thelateperseus/ball-and-plate/README.md

Ball and Plate Balancing System
===============================

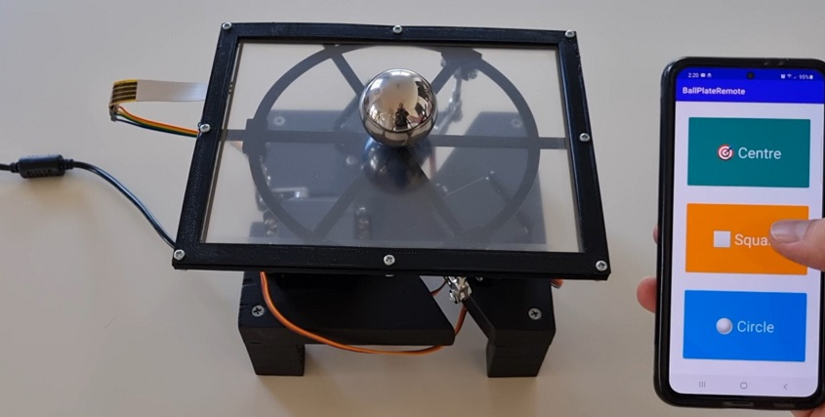
[picture p1: instructions/BallAndPlate.jpg]


https://youtu.be/56UyDa0NHvM

If you're interested in building one of your own, check out the [instructions](instructions/README.md).
