thelateperseus/ball-and-plate/instructions/Parts.md

Parts List
==========

All prices are in Australian Dollars.

Note that I am not making any statement about the quality of these parts. I used them in my build, but you should review the parts to make sure they are suitable for your purpose.

Mechanism
---------

| Part  | Price | Quantity |
| --- | --- | --- |
| [18mm thick pine panel](https://www.bunnings.com.au/300-x-18mm-x-1-2m-pine-utility-panel_p0019145) for base, at least 170mm x 150mm | $29.00 | 1 |
| [42mm x 19mm pine DAR](https://www.bunnings.com.au/porta-42-x-19mm-1-8m-premium-pine-dar_p0211230) for legs | $6.75 | 1 |
| [Aluminum Standoff: 1/4" Length, 2-56 Thread, M-F (4-Pack)](https://core-electronics.com.au/aluminum-standoff-1-4-length-2-56-thread-m-f-4-pack.html) | $2.05 | 1 |
| [Machine Screw: #2-56, 1/4" Length, Phillips (25-pack)](https://core-electronics.com.au/machine-screw-2-56-1-4-length-phillips-25-pack.html) | $1.65 | 1 |
| [4X MG996R Digital Metal Gear Servo](https://www.banggood.com/4X-MG996R-Digital-Metal-Gear-Servo-For-Robot-ZOHD-Volantex-Airplane-RC-Helicopter-Car-Boat-Model-p-961727.html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) | $36.73 | 1 |
| [Multifunction Servo Motor Bracket Steering Head for MG996R](https://www.ebay.com.au/itm/172475926539) | $4.48 | 3 |
| [1PC Aluminum 28.3mm 25T Teeth Tooth Steering Half Servo Arm Horn for 1/10 Rc Car HSP Wltoys - Silver](https://www.banggood.com/1PC-Aluminum-28_3mm-25T-Teeth-Tooth-Steering-Half-Servo-Arm-Horn-for-1-or-10-Rc-Car-HSP-Wltoys-p-1335836.html?ID=227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) | $9.03 | 3 |
| [M4 Aluminum Fisheye Ball Bearing Rod Ends Joint](https://www.banggood.com/M3-or-M4-Aluminum-Fisheye-Ball-Bearing-Rod-Ends-Joint-Thread-Fish-Eye-For-3D-Printer-p-1304307.html?ID=514514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) | $2.45 | 3 |
| [G-FORCE ALUMINIUM CLEVIS HEAVY DUTY M4 (X2)](https://www.frontlinehobbies.com.au/g-force-aluminium-clevis-heavy-duty-m4-x2-gf-2110) | $11.99 | 2 |
| [8" 4 Wire Resistive LCD Touch Screen](https://www.ebay.com.au/itm/180926055286) | $30.99 | 1 |
| [M3 x 10mm Steel Screws - Pk.25](https://www.jaycar.com.au/m3-x-10mm-steel-screws-pk-25/p/HP0403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) | $3.00 | 1 |
| [3mm Flat Steel Washers - Pk.25](https://www.jaycar.com.au/3mm-flat-steel-washers-pk-25/p/HP0430) | $3.00 | 1 |
| [M4 x 20mm Zinc Plated Round Head Bolts And Nuts - 16 Pack](https://www.bunnings.com.au/pinnacle-m4-x-20mm-zinc-plated-round-head-bolts-and-nuts-16-pack_p0168397) | $3.56 | 1 |
| [30mm M4 screws for servo brackets - 100 Pack](https://au.element14.com/tr-fastenings/m4-30-prstmc-z100/screw-pozi-pan-steel-bzp-m4x30/dp/1419998) | $4.32  | 1 |
| [M4 Steel Flat Washer - Pk.25](https://www.jaycar.com.au/m4-steel-flat-washer-pk-25/p/HP0465) | $3.50 | 1 |
| M4 nuts | ??? | 15 |
| M3 nuts | ??? | 11 |
| 8G self-tapping screws for legs | ??? | 4 |

Electronics
---------

| Part  | Price | Quantity |
| --- | --- | --- |
| [Arduino Nano Every](https://core-electronics.com.au/arduino-nano-every.html) | $22.95 | 1 |
| [Pololu 5V Step-Up/Step-Down Voltage Regulator S7V7F5](https://core-electronics.com.au/pololu-5v-step-up-step-down-voltage-regulator-s7v7f5.html) | $19.60 | 1 |
| [Bluetooth Module (HC-05)](https://core-electronics.com.au/bluetooth-module-hc-05.html) | $33.50 | 1 |
| [DC POWER JACK, 8A, 20VDC, BLACK](https://au.element14.com/global-connector-technology/dcj250-20-b-k1-a/dc-power-jack-8a-20vdc-black/dp/2524132) | $2.10 | 1 |
| [Electrolytic Decoupling Capacitors - 1000uF/25V](https://core-electronics.com.au/electrolytic-decoupling-capacitors-1000uf-25v.html) | $0.55 | 1 |
| [Schottky Diode](https://core-electronics.com.au/schottky-diode.html) | $0.24 | 1 |
| 180 Ohm resistor | ??? | 1 |
| 1k Ohm resistor | ??? | 1 |
| 2k Ohm resistor | ??? | 1 |
| [T1 (3mm) Yellow LED with Yellow Diffused Lens](https://core-electronics.com.au/t1-3mm-yellow-led-with-yellow-diffused-lens.html) | $0.30 | 1 |
| [0.100" (2.54 mm) Female Header: 1x3-Pin, Straight](https://core-electronics.com.au/0-100-2-54-mm-female-header-1x3-pin-straight.html) | $0.54 | 1 |
| [0.100" (2.54 mm) Female Header: 1x6-Pin, Right-Angle](https://core-electronics.com.au/0-100-2-54-mm-female-header-1x6-pin-right-angle.html) | $0.78 | 1 |
| [0.100" (2.54 mm) Breakaway Male Header: 1x40-Pin, Straight](https://core-electronics.com.au/0-100-2-54-mm-breakaway-male-header-1x40-pin-straight.html) | $1.20 | 1 |
| [40 Pin - Female Headers](https://core-electronics.com.au/female-headers.html) | $2.40 | 1 |
| [Jumper (busbar)](https://au.element14.com/wurth-elektronik/60910813421/jumper-8pos-2-54mm-header-conn/dp/2827863) | $1.31 | 1 |
| [MICRO USB Metal Dust Plug Cover](https://www.ebay.com.au/itm/283712585867) | $3.95 | 1 |

Other
---------

| Part  | Price | Quantity |
| --- | --- | --- |
| [AC DC Power Supply 5V 8A Transformer 40W Adapter 10A AU Plug](https://www.ebay.com.au/itm/123865462464) | $31.85 | 1 |
| [Precision Ball 38mm Solid Chrome Steel G25 for Bearing](https://www.ebay.com.au/itm/352871824460) | $15.43 | 1 |
