thelateperseus/ball-and-plate/CADv2/mservobracket.stl

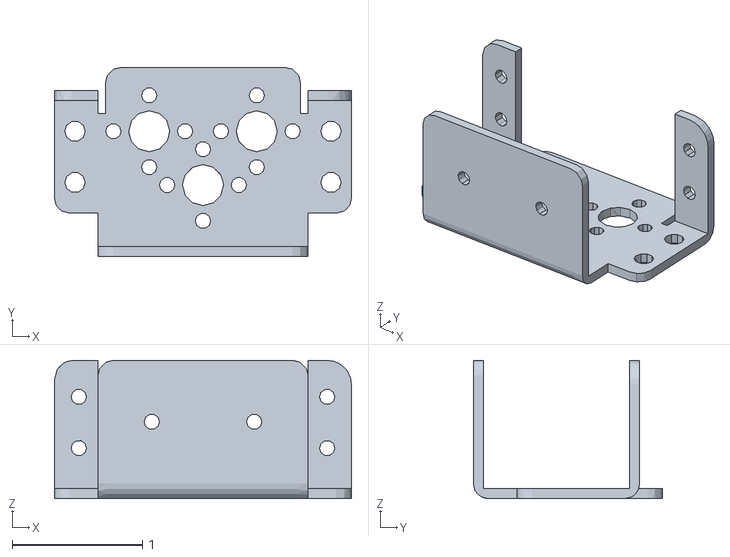
[picture p2: CAD file, 2021-02-15]
CADv2/mservobracket.stl
2.28 x 1.46 x 1.06
