thelateperseus/ball-and-plate/CADv2/Topside.stl

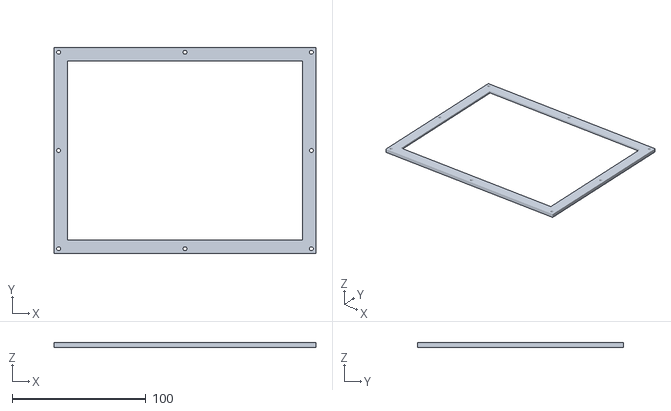
[picture p3: CAD file, 2021-02-15]
CADv2/Topside.stl
196.0 x 154.0 x 3.50
