thelateperseus/ball-and-plate/CADv2/Panel Border.stl

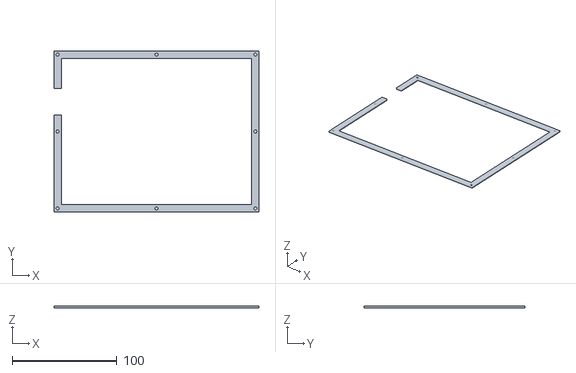
[picture p4: CAD file, 2021-02-15]
CADv2/Panel Border.stl
196.0 x 154.0 x 1.50
