thelateperseus/ball-and-plate/CADv2/Base v11.step

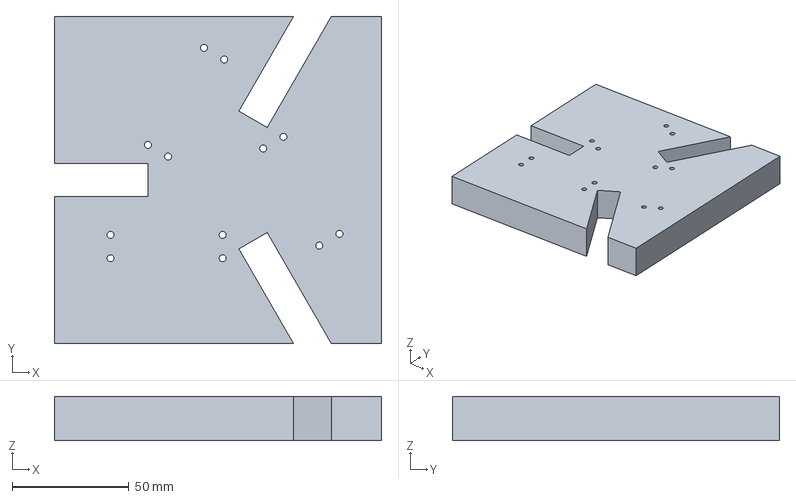
[picture p5: CAD file, 2021-02-15]
CADv2/Base v11.step
140.0 x 140.0 x 19.0 mm
