thelateperseus/ball-and-plate/CADv2/Multi Purpose Bracket.SLDPRT

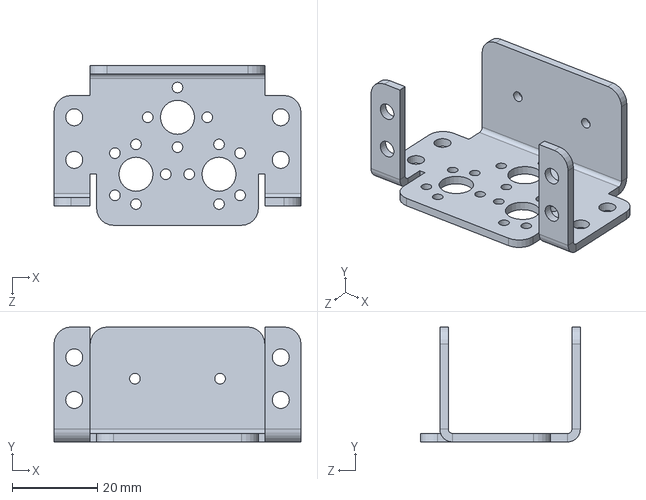
[picture p6: CAD file, 2021-02-15]
CADv2/Multi Purpose Bracket.SLDPRT
58.0 x 27.0 x 37.5 mm
