thelateperseus/ball-and-plate/CADv2/Panel Top.stl

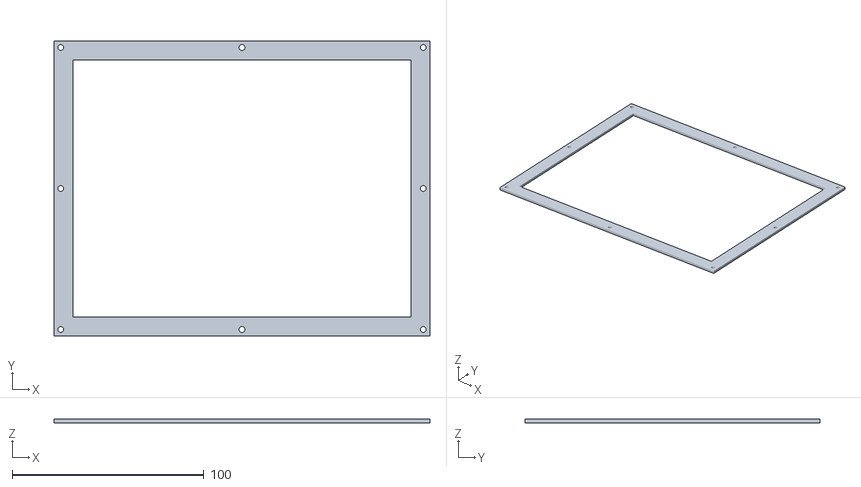
[picture p7: CAD file, 2021-02-15]
CADv2/Panel Top.stl
196.0 x 154.0 x 2.00
