thelateperseus/ball-and-plate/CADv2/Underside.stl

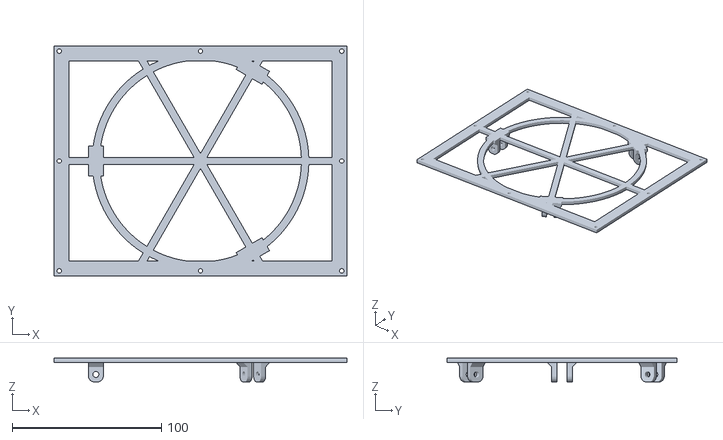
[picture p8: CAD file, 2021-02-15]
CADv2/Underside.stl
196.0 x 154.0 x 16.0
