thelateperseus/ball-and-plate/CADv2/Plate Support v12.step

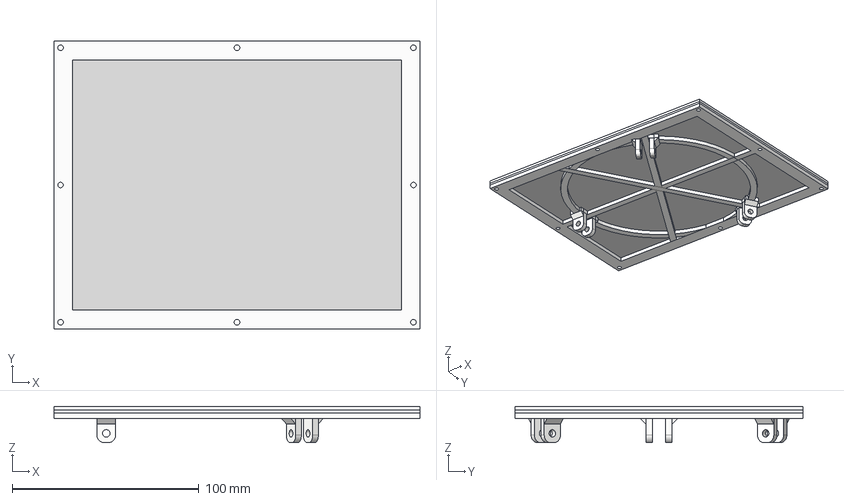
[picture p9: CAD file, 2021-02-15]
CADv2/Plate Support v12.step
196.0 x 154.0 x 19.5 mm
Bracket Arm x 3
Connecting Circle
Touch Panel
Topside
