thelateperseus/ball-and-plate/CADv2/Base v7.step

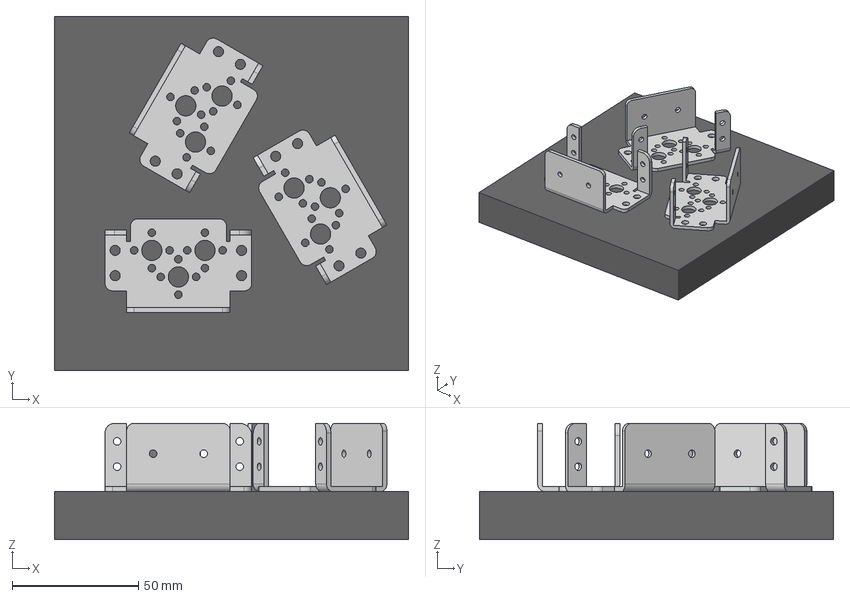
[picture p10: CAD file, 2021-02-15, an earlier design]
CADv2/Base v7.step
140.0 x 140.0 x 46.0 mm
MservoBracket x 3
servo_mg996 x 3
