thelateperseus/ball-and-plate/(list of files, cad)

Other CAD files:
CADv2/Base v11.f3z
CADv2/Base v7.f3z
CADv2/Plate Support v12.f3d
