thelateperseus/ball-and-plate/instructions/README.md

Building a Ball and Plate Balancing System
==========================================

Below are the instructions describing how to build your own ball and plate balancing system.

1. Purchase all the parts from the [parts list](Parts.md).
2. Arrange for the required [manufacturing of components](Manufacturing.md).
3. Assemble the [wooden base](WoodenBase.md).
4. Assemble the [controller PCB](PCB.md) and attach to the base.
5. Attach the [servo motors, arms and plate assembly](ServoArms.md).
6. Upload [controller code](ArduinoCode.md) to the Arduino.
7. Load the [Android app](AndroidApp.md) onto your phone.
