thelateperseus/ball-and-plate/instructions/AndroidApp.md

Android App
===========

1. Download Android Studio and open the [BallPlateRemote](../BallPlateRemote) folder.
2. Install the appropriate USB driver for your phone. See [Install OEM USB drivers](https://developer.android.com/studio/run/oem-usb).
3. Enable USB debugging on your phone.
4. Pair your phone with the bluetooth module on the PCB.
5. Connect your phone to your computer via USB and run the app on your phone.
6. Unplug the USB cable from your phone. The app is now installed on your phone.
