thelateperseus/ball-and-plate/CADv2/BasePlate.pdf

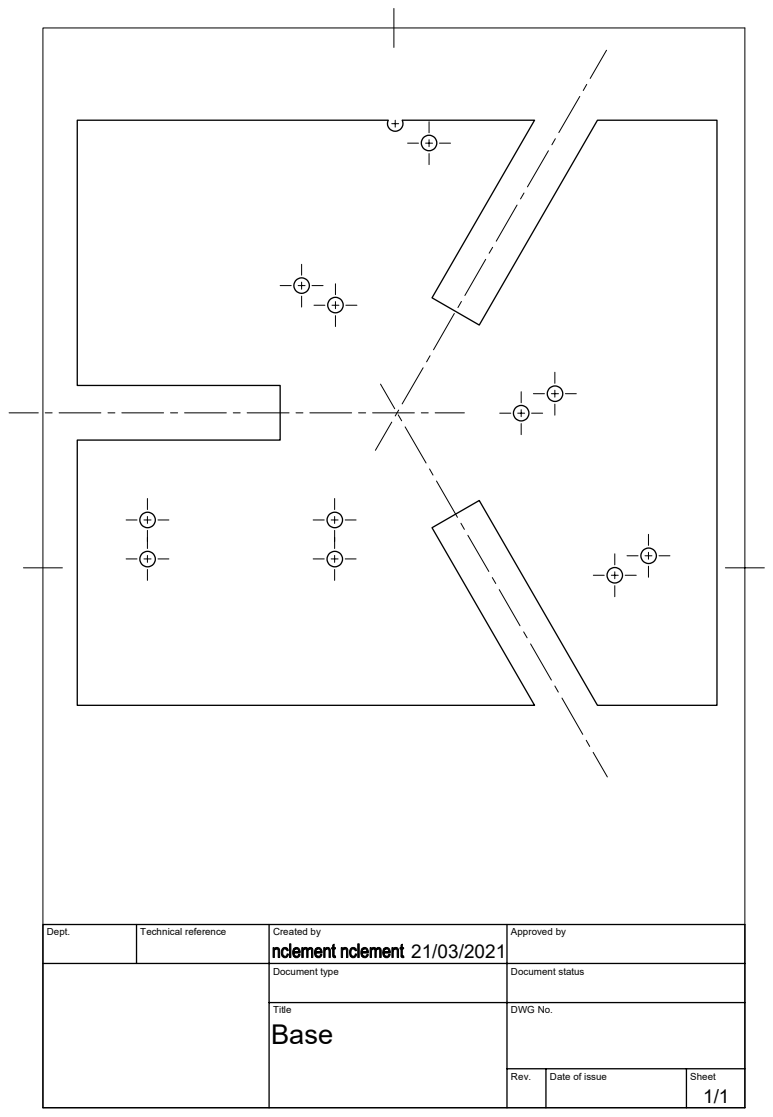
[picture p15: page 1]
Dept.; Technical reference; Created by; Approved by; Document type; Document status; Title; DWG No.; Rev.; Date of issue; Sheet; Base
