thelateperseus/ball-and-plate/TouchPanelAdafruit/TouchPanelAdafruit.ino

// Touch screen library with X Y and Z (pressure) readings as well
// as oversampling to avoid 'bouncing'
// This demo code returns raw readings, public domain

//#define NUMSAMPLES 1

#include <stdint.h>
#include "TouchScreen.h"

#define YP A0  // must be an analog pin, use "An" notation!
#define XM A3  // must be an analog pin, use "An" notation!
#define YM A2   // can be a digital pin
#define XP A1   // can be a digital pin

// For better pressure precision, we need to know the resistance
// between X+ and X- Use any multimeter to read it
// For the one we're using, its 300 ohms across the X plate
TouchScreen ts = TouchScreen(XP, YP, XM, YM, 330);

void setup(void) {
  Serial.begin(115200);
}

void loop(void) {
  // a point object holds x y and z coordinates
  TSPoint p = ts.getPoint();
  
  // we have some minimum pressure we consider 'valid'
  // pressure of 0 means no pressing!
  //if (p.z > ts.pressureThreshhold) {
     Serial.print("X:"); Serial.print(p.x);
     Serial.print(", Y:"); Serial.print(p.y);
     //Serial.print(", Pressure:"); Serial.print(p.z);
     Serial.println();
  //}

  delay(20);
}
