thelateperseus/ball-and-plate/(commit log)

2020-05-10 Initial version of code using PixyCam
    Small orange plastic marble-run ball on a cardboard surface. PixyCam reports ball position.
    [BallPlate.fzz, PAN-TILT_BASE_V1.stl, Plate Support v2.stl, Plate Support v3.1.stl, Plate Support v3.2.stl, Plate Support v3.stl, Plate Support.stl, hitec_horn_h25t.stl]
2021-02-15 Use resistive touch panel instead of PixyCam
    A resistive touch panel measures the position of the steel ball rather
    than PixyCam detecting a coloured ball. The steel ball must be ~80g or
    heavier to be detected by the touch panel.
    I would like to use a lighter ball when tuning the PID controller so
    that there is less momentum when the ball falls off the plate :)
    Observed that with lighter balls, some readings are dropped from the
    touch panel. Rather than using a low-pass filter, the best option seems
    to be to use the last reading when this occurs.
    I'm concerned that the servo movement is a bit jerky when running the
    plate rotate program. I assume that this means there may be some error
    in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
    [Base v11.f3z, Base v11.step, Base v7.f3z, Base v7.step, Multi Purpose Bracket.SLDPRT, Panel Border.stl, Panel Top.stl, Plate Support v12.f3d]
2021-02-16 Smarter detection of missed ball position readings
    Sometimes the touch panel does not read correctly with a lighter ball.
    This usually results in a zero x value, but sometimes can result in a
    spike in the x or y value. Detect these errors and use the last good
    reading instead.
    [BallPlatePosition.ino]
2021-02-18 Kind of stable PID control
    - Applied position measurement correction to PID control program.
    - Basic PID tuning to stop ball falling off plate.
    - Reset PID controller when ball removed from plate.
    - Found that delayMicroseconds didn't work for values ~20ms.
    - Write a while-loop for the delay instead.
    [BallPlateControl.ino, BallPlatePosition.ino]
2021-02-22 Tweaked PID constants and added bluetooth control
    Improved responsiveness by doubling KP, and slightly increasing KD.
    Higher values of KI or KD result in increased oscillations close to
    steady state. The ball is never perfectly still, so the plate is never
    still either. The best controller constants have lead to minimal
    oscillations, but never eliminated. Deacreasing KD too much results in
    instability because the plate is not tilted to brake the speed as the
    ball approaches the setpoint.
    Also restored the code for bluetooth control and tweaked the setpoints
    for the square and circle patterns.
    [BallPlateControl.ino]
2021-02-25 Tweaked position filtering code
    The position filtering code would sometimes detect a spike but then the
    raw position would have changed rapidly so that it though the readings
    were perpetual spikes. Changed the code to ignore a only a single
    reading for a spike.
    Also moved position filtering code to its own class and experimented
    with adding a low pass filter on the ball position output. This gave no
    real improvement, but increased the impact of the spike due to settling
    time of the filter.
    Sometimes we get a double-reading spike, so maybe we can change the code
    to allow for that rare occurrence when using the smallest ball.
    Also experimented with various PID controller constant values and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
2021-02-27 Position filter to handle 2 consecutive spikes
    Change the code to allow the position filter to ignre up to 2
    consecutive spike readings. Spikes are normally only on single readings
    but very occasionaly a second one occurs.
    Also experimented with low pass filters and found that a first order
    filter at 5Hz was best. However, the extra delay in ball position made
    the system oscillate more.
    Watching the motor movement made me wonder about using shorter servo
    arms since this would effectively increase the accuracy of the existing
    servos without having to buy new ones.
    [BallPlatePosition.ino, BallPositionFilter.cpp, BallPositionFilter.h]
2021-03-20 Switch to Servo library using new board for power
    My new Servo Power PCB arrived and this update switches from the PCA9685
    external PWM driver to the Arduino Servo library. This theoretically
    allows for higher precision due to the writeMicroseconds function
    allowing ~10bit precision instead of ~8bit. However, the servos may not
    be that accurate due to deadband.
    Also replaced the generic Arduino Nano v3 with a genuine Arduino Nano
    Every. The new microcontroller runs at 20MHz, ideally giving a more
    accurate PWM signal for the servos, and includes a second serial port
    removing the need for the SoftwareSerial library for Bluetooth
    communication (although this is still TODO).
    Re-tuned the PID c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
    [BallPlateControl.ino, BallPlatePosition.ino, BallPositionFilter.cpp, BallPositionFilter.h, LevelBoard.ino, PlateRotate.ino]
2021-03-20 Adjustments for new Servos
    Swapped the generic MG996R for JX PDI-6113MG and made corresponding
    changes to the code. The new servos seem to have 90 degrees of rotation
    compared to the 180 degrees of the MG996Rs. Changed the formula to
    compute the angle accordingly, and changed the centre positions for the
    new servos.
    The end result was a bit of a disaster. The new servos are very jittery
    (and noisy), and do not hold the plate position well. With the power
    off, the plate slowly sinks until it reaches some kind of equilibrium.
    With the power on, the servos and the plate vibrate a lot. When
    controlling the ball, the vibrations sometimes get more violent,
    especially when the ball nears the edges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
    [BallPlateControl.ino, LevelBoard.ino, PlateRotate.ino]
2021-03-21 Updated constants for short servo arms
    Switched back to MG996R servos with short servo arms (20mm instead of
    37mm). The end result is that the ball stays closer to the setpoint
    than before. There is still some continual movement of the ball, but the
    plate does not move as much as with the longer servo arms. The effect
    error in the servo position has been reduced as intended. It's not
    perfect, but it's an improvement.
    I will try to compute the formula for how the servo angle affects the
    plate angle. If this looks non-linear, then I may reverse this so that
    the PID controller sets the plate angle, which is then translated into
    the servo angle. This may improve the performance of the PID contr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
    [BallPlateControl.ino, LevelBoard.ino, PlateRotate.ino]
2021-03-22 User Serial1 instead of SoftwareSerial
    The Arduino Nano Every supports 2 serial ports - one over USB, and one
    via pins RX and TX. This saves having to use SoftwareSerial for
    Bluetooth comms.
2021-03-24 Replaced servo[1] with spare MG996R
    Servo[1] was exhibiting some jerkiness when moving and seemed to be less
    precise than the others. I replaced it with the spare MG996R and the
    result was good. The ball stays closer to the setpoint than before.
    I then gave the JX servos one last try, thinking that the reduced torque
    due to the shorter servo arms may reduce the jitter. However, even with
    no ball on the plate, the servos click like a geiger counter. Placing
    the ball on the plate makes the servos louder, and they still jump about
    when the ball is close to the edge of the plate. This happens less than
    with the longer servo arms, but the result is still unacceptable.
    I then reverted back to th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
    [BallPlateControl.ino, LevelBoard.ino, PlateRotate.ino]
2021-03-28 Android app to control setpoint via Bluetooth
    First version of the app which just allows to switch between the 3
    setpoint modes of centre, square or circle.
2021-10-15 Added high-level instructions and manufacturing
    [BallPlate.fzz, PAN-TILT_BASE_V1.stl, Plate Support v2.stl, Plate Support v3.1.stl, Plate Support v3.2.stl, Plate Support v3.stl, Plate Support.stl, hitec_horn_h25t.stl]
2021-10-17 Added instructions for plate mechanism
2021-10-17 Added PCB assembly
2021-10-17 Added photo of assembled PCB
2021-10-18 Added Arduino code and Android app instructions
2021-10-18 Added note to reduce cut-out channel length
